mamejay/Amiga-USB-C-PD-Power-Supply/rev1.1/docs/renders/board_iso.png

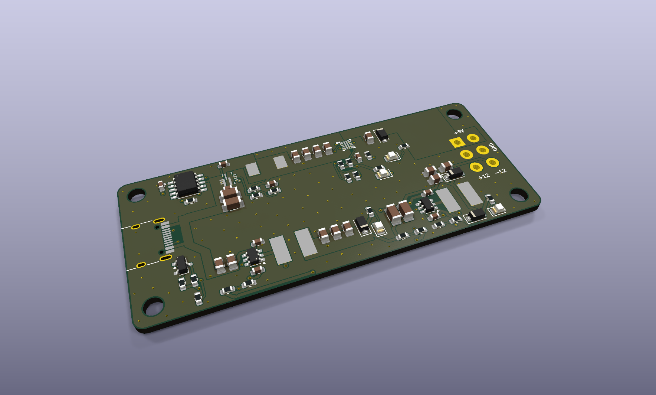
rev1.1/docs/renders/board_iso.png
