mamejay/Amiga-USB-C-PD-Power-Supply/rev1.1/docs/renders/board_top.png

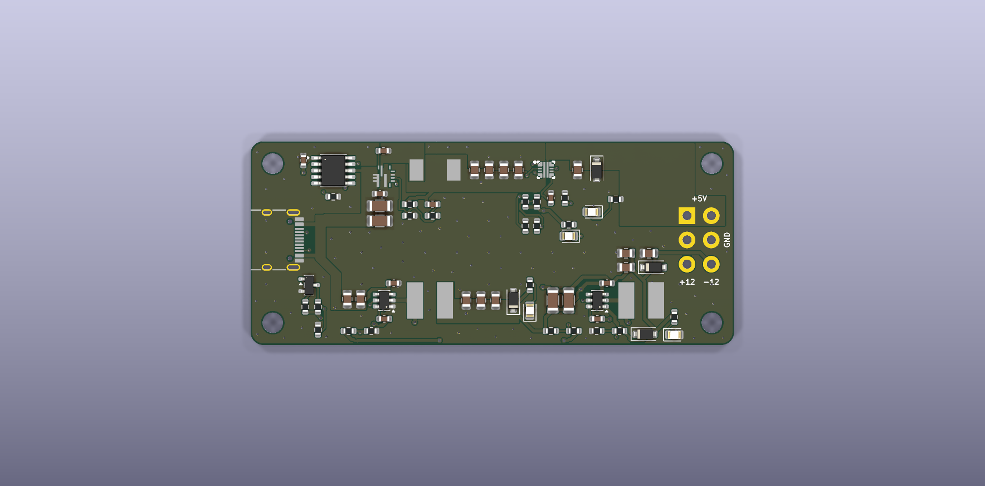
rev1.1/docs/renders/board_top.png
