mamejay/Amiga-USB-C-PD-Power-Supply/README.md

# Amiga USB-C PD Power Supply

A compact power supply that runs a Commodore **Amiga 500 / 600 / 1200** from a USB-C PD charger.
It asks the charger for **15 V** and makes the three Amiga rails on board:

| Rail | Converter | Set point | Rating | Protection |
|---|---|---|---|---|
| +5 V | Silergy SY8205 5 A sync buck → TI TPS259470A eFuse | 5.10 V | **4.5 A continuous** (same as the Commodore A500 PSU; eFuse limit ~5.4 A typ, 4.8 A min) | eFuse cuts the output above **5.64 V** (failed buck can't reach the Amiga), current limit, ~5 ms soft start, SMF5.0A TVS, red fault LED |
| +12 V | TI LMR51430 3 A sync buck | 12.36 V | 1.5 A (Commodore A500 PSU: 1 A; floppy / RS-232 / audio / expansion) | cycle-by-cycle limit + hiccup, SMF13A TVS |
| −12 V | TI LMR51430 as inverting buck-boost (from +12 V) | −12.36 V | 0.5 A+ (Commodore PSU: 0.1 A) | hiccup limit, Schottky clamp against positive excursions, SMF13A TVS |

Input power budget is 45 W (15 V × 3 A), e.g. 5 V 4.5 A + 12 V 1 A + −12 V 0.2 A ≈ 37 W out.
The converters only start once the charger has agreed 15 V (CH224A power-good) **and** VBUS is above ~11.5 V,
so a 5 V-only or non-PD source never powers the Amiga.

## Charger / cable
* USB-C **PD** charger that offers **15 V at 3 A** (any 45 W+ PD charger; 65 W recommended).
* USB-C to USB-C cable rated 3 A or more (normal 60 W cables are fine).

## Board
* **76 × 32 mm** slim board (rev 1.1 / 1.2), 2 layers, 1.6 mm, 1 oz. All SMD parts on the top side (JLCPCB economic PCBA).
* 4 × M3 mounting holes.
* **Cable pads (J2)**, a 2 × 3 block at the right-hand end, 1.4 mm holes (up to 18 AWG). Solder a ready-made Amiga square DIN-5 power cable:

  | Row (top to bottom) | Left pad | Right pad |
  |---|---|---|
  | 1 | +5 V (pad 1, square) | +5 V (pad 2) |
  | 2 | GND (pad 3) | GND (pad 4) |
  | 3 | +12 V (pad 5) | −12 V (pad 6) |

  **Identify every wire of the DIN cable with a multimeter against the Amiga power socket pinout before soldering.**
  Cable wire colours are not standard between suppliers.

* LEDs: green +5 V, green +12 V, green −12 V, red = 5 V eFuse fault.

## Two versions

| | **Rev 1.2** (repo root, recommended) | **Rev 1.1** (`rev1.1/` folder, higher capacity) |
|---|---|---|
| 5 V buck | SY8205, 5 A | TPS56637, 6 A |
| +5 V rating | 4.5 A continuous | **5 A continuous** |
| Parts per board (10 off) | about US$5.37 | about US$7.30 |

Everything else (board size, cable pads, ±12 V) is the same. Rev 1.1 suits heavily expanded machines; see `rev1.1/README.md`.

## Files
* `hw/` – KiCad 10 project (schematic, PCB, project symbol + footprint libraries, DRC/ERC reports).
* `fab/` – JLCPCB order files: Gerbers zip, BOM, CPL and `ORDER NOTES.md`.
* `scripts/` – the generators: `gen_sch.py` (schematic), `place.py` + `build_pcb.py` (placement/board),
  `full.sh` (net classes → Freerouting → pours → GND stitching → DRC loop), `make_fab.py`, `bom_cost.py`.
* `rev1.1/` – complete rev 1.1 (5 A) KiCad project, JLC files and design notes.
* `datasheets/` – not committed (vendor copyright); see the links in `docs/DESIGN.md`.

## Status
Rev 1.2 (cost-down of the slim 76 × 32 mm rev 1.1: SY8205 5 V buck, Fojan 22 µF caps) – routed, ERC 0 / DRC 0
(only 2 cosmetic USB-C silk-at-edge marks), JLC files generated, **not yet built**.
Parts ≈ US$5.37 per board at 10 boards (JLC prices 2026-11-03), 8 extended parts, every part Economic-PCBA eligible.
Rev 1.1 (5 A) is in `rev1.1/` and tagged `v1.1`; rev 1.0 (64 × 46 mm) is tagged `v1.0`. See `docs/DESIGN.md` for the calculations and the bring-up checklist.

## Licence
Copyright © 2026 mamejay. All rights reserved (commercial product). See `LICENSE` and `NOTICE.md`.
