mamejay/Amiga-USB-C-PD-Power-Supply/rev1.1/docs/renders/board_bottom.png

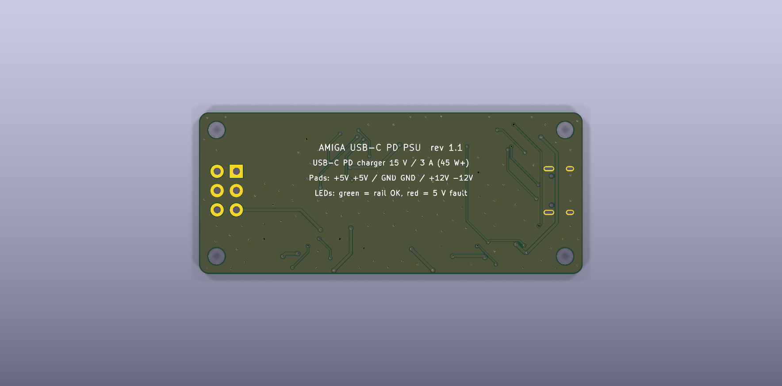
rev1.1/docs/renders/board_bottom.png
