mamejay/Amiga-USB-C-PD-Power-Supply/rev1.1/docs/renders/copper_top.png

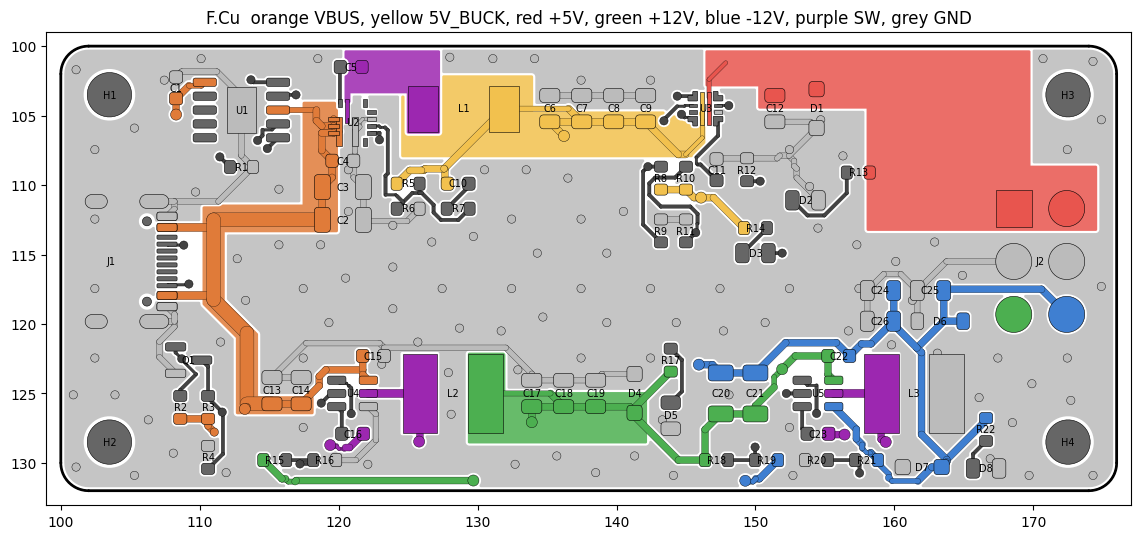
rev1.1/docs/renders/copper_top.png
