mamejay/Amiga-USB-C-PD-Power-Supply/rev1.1/docs/renders/schematic-1.png

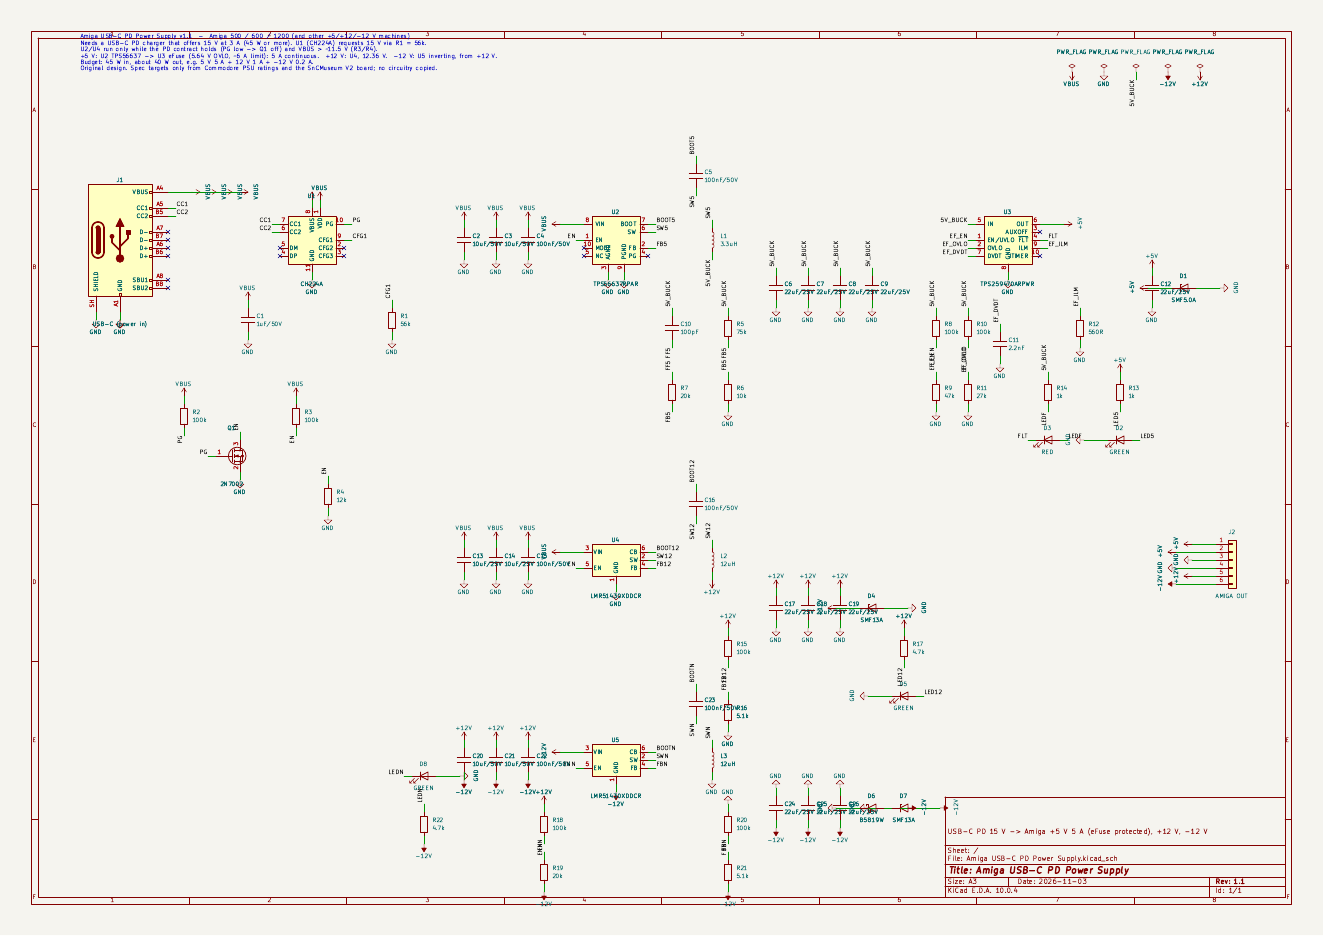
rev1.1/docs/renders/schematic-1.png
