mamejay/Amiga-USB-C-PD-Power-Supply/rev1.1/fab/Amiga USB-C PD Power Supply - BOM.csv

Comment | Designator | Footprint | LCSC Part #
1uF/50V | C1 | 0603 | C15849
10uF/50V | C2,C3,C20,C21 | 1206 | C13585
100nF/50V | C4,C5,C15,C16,C22,C23 | 0603 | C14663
22uF/25V | C6,C7,C8,C9,C12,C17,C18,C19,C24,C25,C26 | 0805 | C7419435
100pF | C10 | 0603 | C14858
2.2nF | C11 | 0603 | C1604
10uF/25V | C13,C14 | 0805 | C15850
SMF5.0A | D1 | SOD-123F | C19077497
GREEN | D2,D5,D8 | 0805 | C2297
RED | D3 | 0805 | C84256
SMF13A | D4,D7 | SOD-123F | C41376087
B5819W | D6 | SOD-123 | C8598
USB-C (power in) | J1 | TYPE-C-31-M-12 | C165948
3.3uH | L1 | CMLO0650H | C439008
12uH | L2,L3 | L_FH_FNR6045 | C168077
2N7002 | Q1 | SOT-23 | C8545
56k | R1 | 0603 | C23206
100k | R2,R3,R8,R10,R15,R18,R20 | 0603 | C25803
12k | R4 | 0603 | C22790
75k | R5 | 0603 | C23242
10k | R6 | 0603 | C25804
20k | R7,R19 | 0603 | C4184
47k | R9 | 0603 | C25819
27k | R11 | 0603 | C22967
560R | R12 | 0603 | C23204
1k | R13,R14 | 0603 | C21190
5.1k | R16,R21 | 0603 | C23186
4.7k | R17,R22 | 0603 | C23162
CH224A | U1 | SSOP-10 | C42459160
TPS56637RPAR | U2 | VQFN-HR-10_3x3 | C841386
TPS259470ARPWR | U3 | VQFN-10-HR_2x2 | C3662799
LMR51430XDDCR | U4,U5 | TSOT-23-6 | C5185863
