mamejay/Amiga-USB-C-PD-Power-Supply/rev1.1/hw/Amiga USB-C PD Power Supply - schematic.pdf

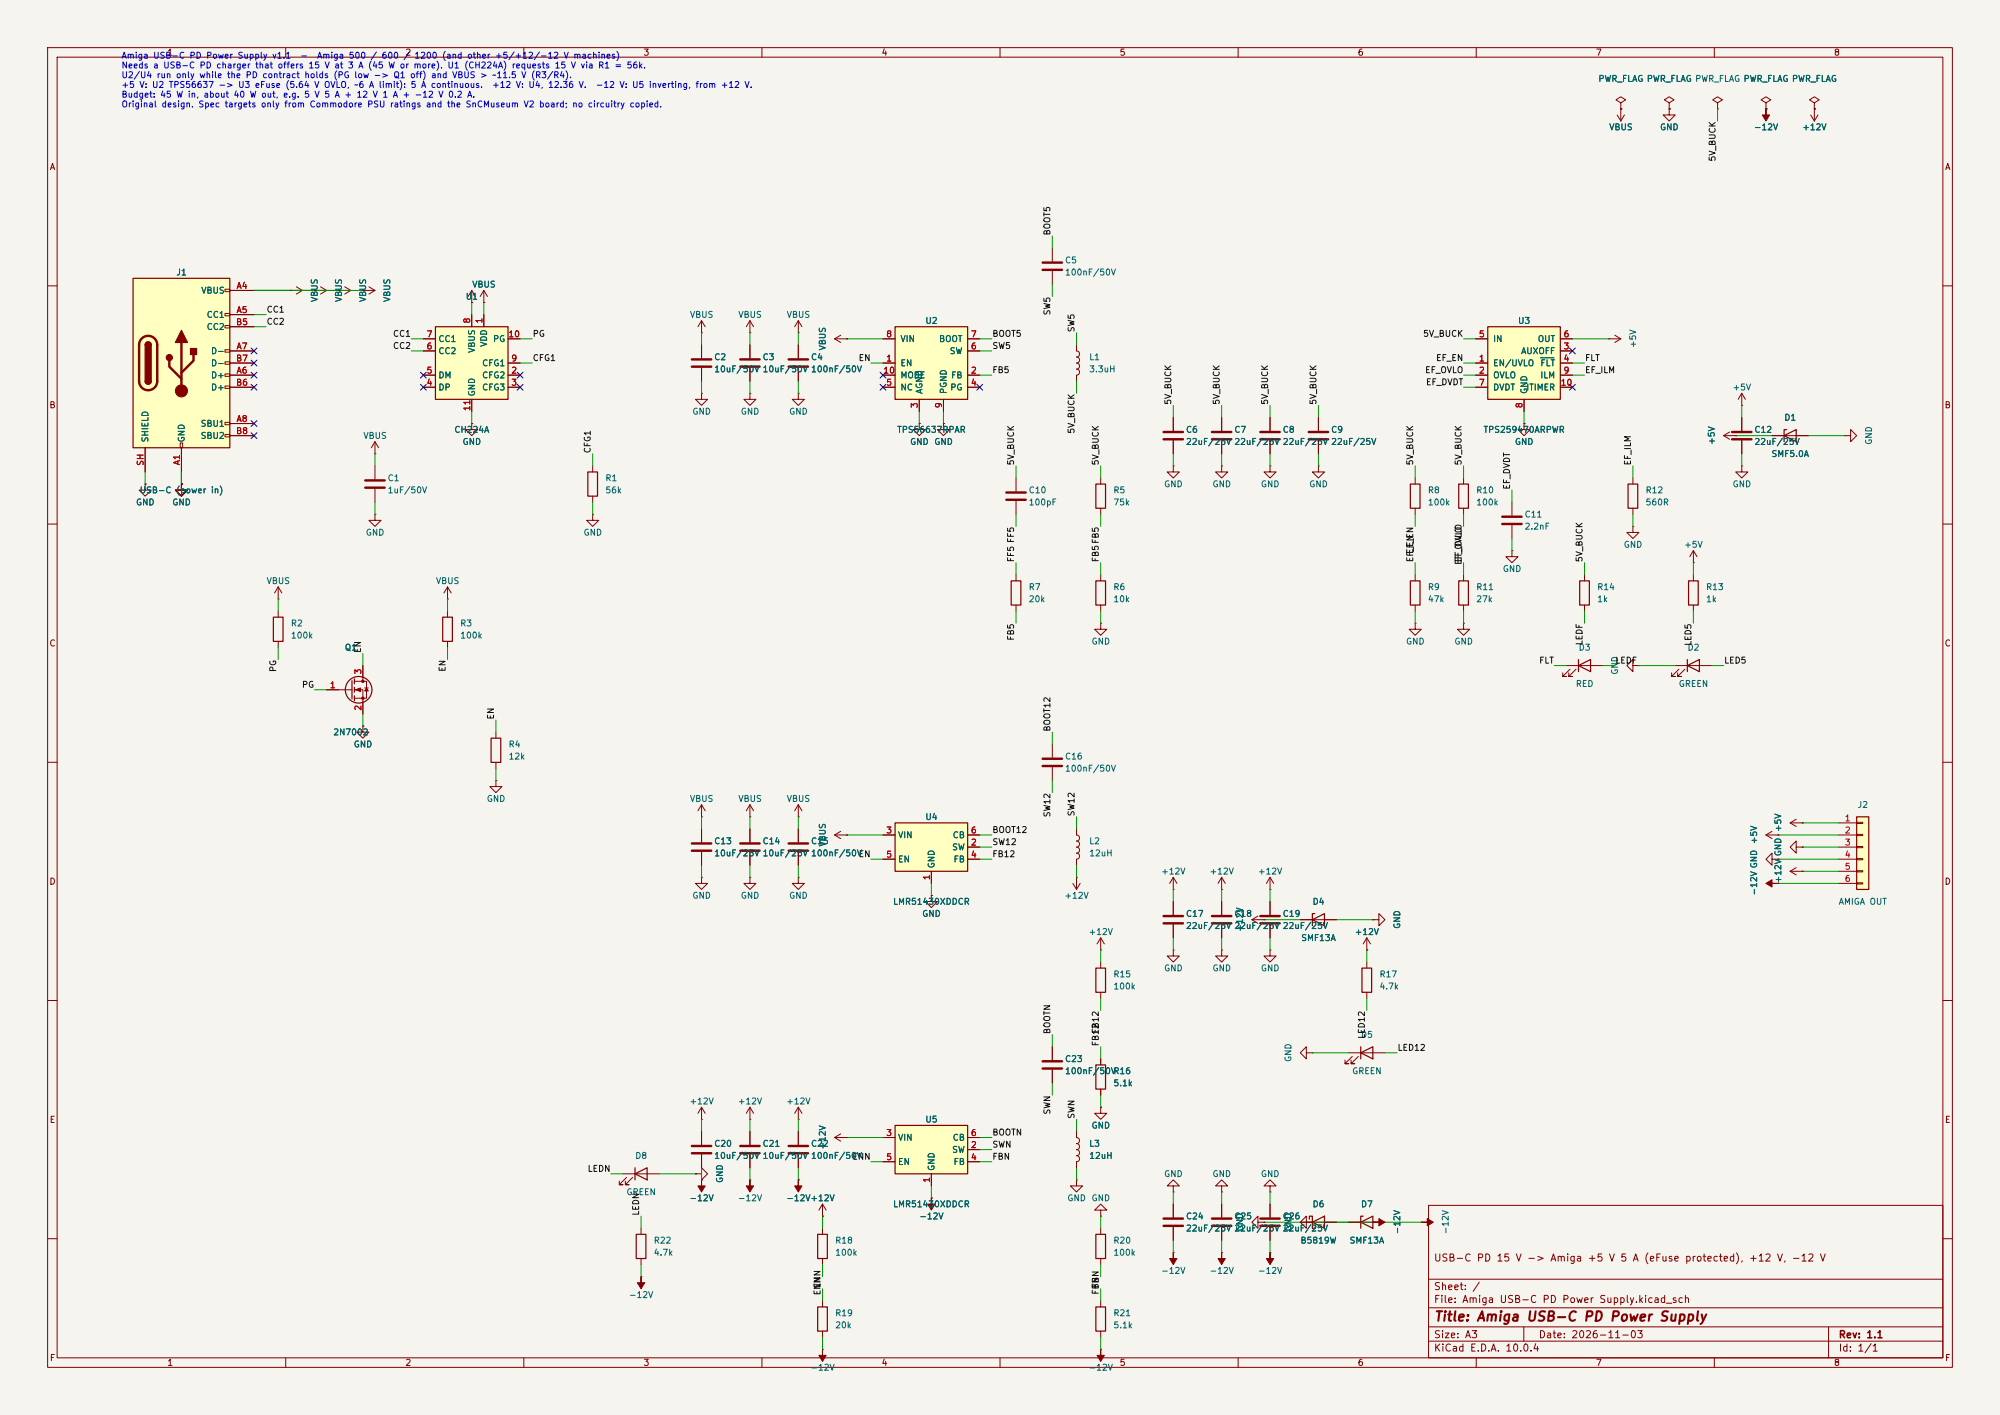
[picture p7: page 1]

J1 USB-C (power in) GND A1

USB-C PD 15 V -> Amiga +5 V 5 A (eFuse protected), +12 V, -12 V

Sheet: /
File: Amiga USB-C PD Power Supply.kicad_sch
Title: Amiga USB-C PD Power Supply

Size: A3 | Rev: 1.1
KiCad E.D.A. 10.0.4 | Id: 1/1 | F Date: 2026-11-03
