mamejay/Amiga-USB-C-PD-Power-Supply/hw/Amiga USB-C PD Power Supply - schematic.pdf

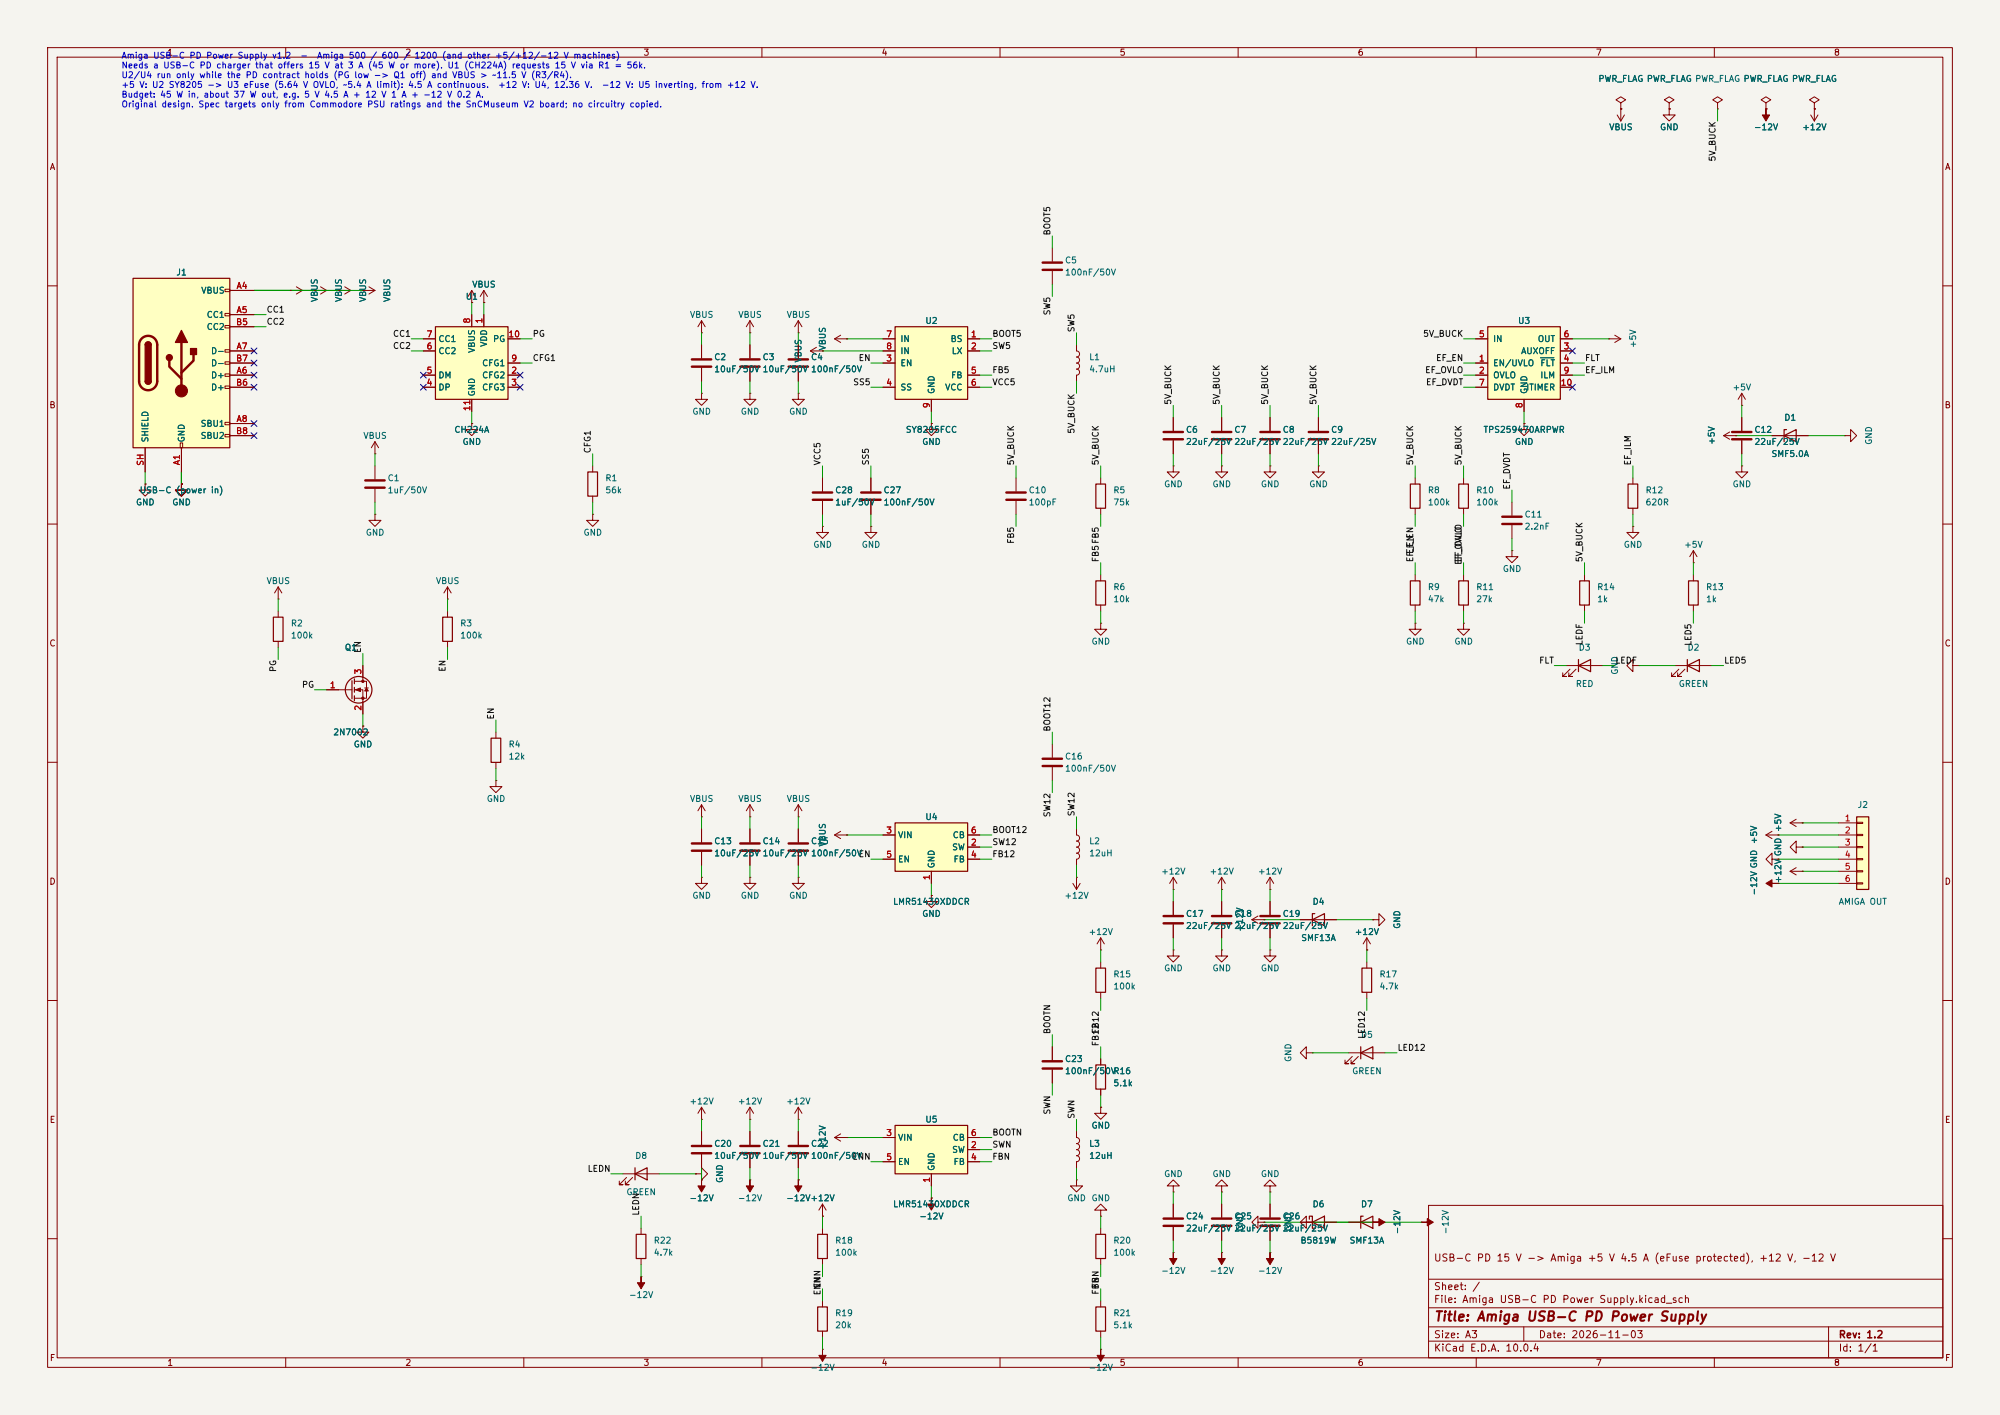
[picture p8: page 1]

Amiga USB-C PD Power Supply v1.2 - Amiga 500 / 600 / 1200 (and other +5/+12/-12 V machines) Needs a USB-C PD charger that offers 15 V at 3 A (45 W or more). U1 (CH224A) requests 15 V via R1 = 56k. U2/U4 run only while the PD contract holds (PG low -> Q1 off) and VBUS > ~11.5 V (R3/R4). +5 V: U2 SY8205 -> U3 eFuse (5.64 V OVLO, ~5.4 A limit): 4.5 A continuous. +12 V: U4, 12.36 V. -12 V: U5 inverting, from +12 V. Budget: 45 W in, about 37 W out, e.g. 5 V 4.5 A + 12 V 1 A + -12 V 0.2 A. Original design. Spec targets only from Commodore PSU ratings and the SnCMuseum V2 board; no circuitry copied. J1 USB-C (power in) GND A1

USB-C PD 15 V -> Amiga +5 V 4.5 A (eFuse protected), +12 V, -12 V

Sheet: /
File: Amiga USB-C PD Power Supply.kicad_sch
Title: Amiga USB-C PD Power Supply

Size: A3 | Rev: 1.2
KiCad E.D.A. 10.0.4 | Id: 1/1 | F Date: 2026-11-03
