mamejay/Amiga-USB-C-PD-Power-Supply/rev1.1/hw/Amiga USB-C PD Power Supply.kicad_pcb

## KiCad design rev1.1/hw/Amiga USB-C PD Power Supply.kicad_pcb (2026-11-03)

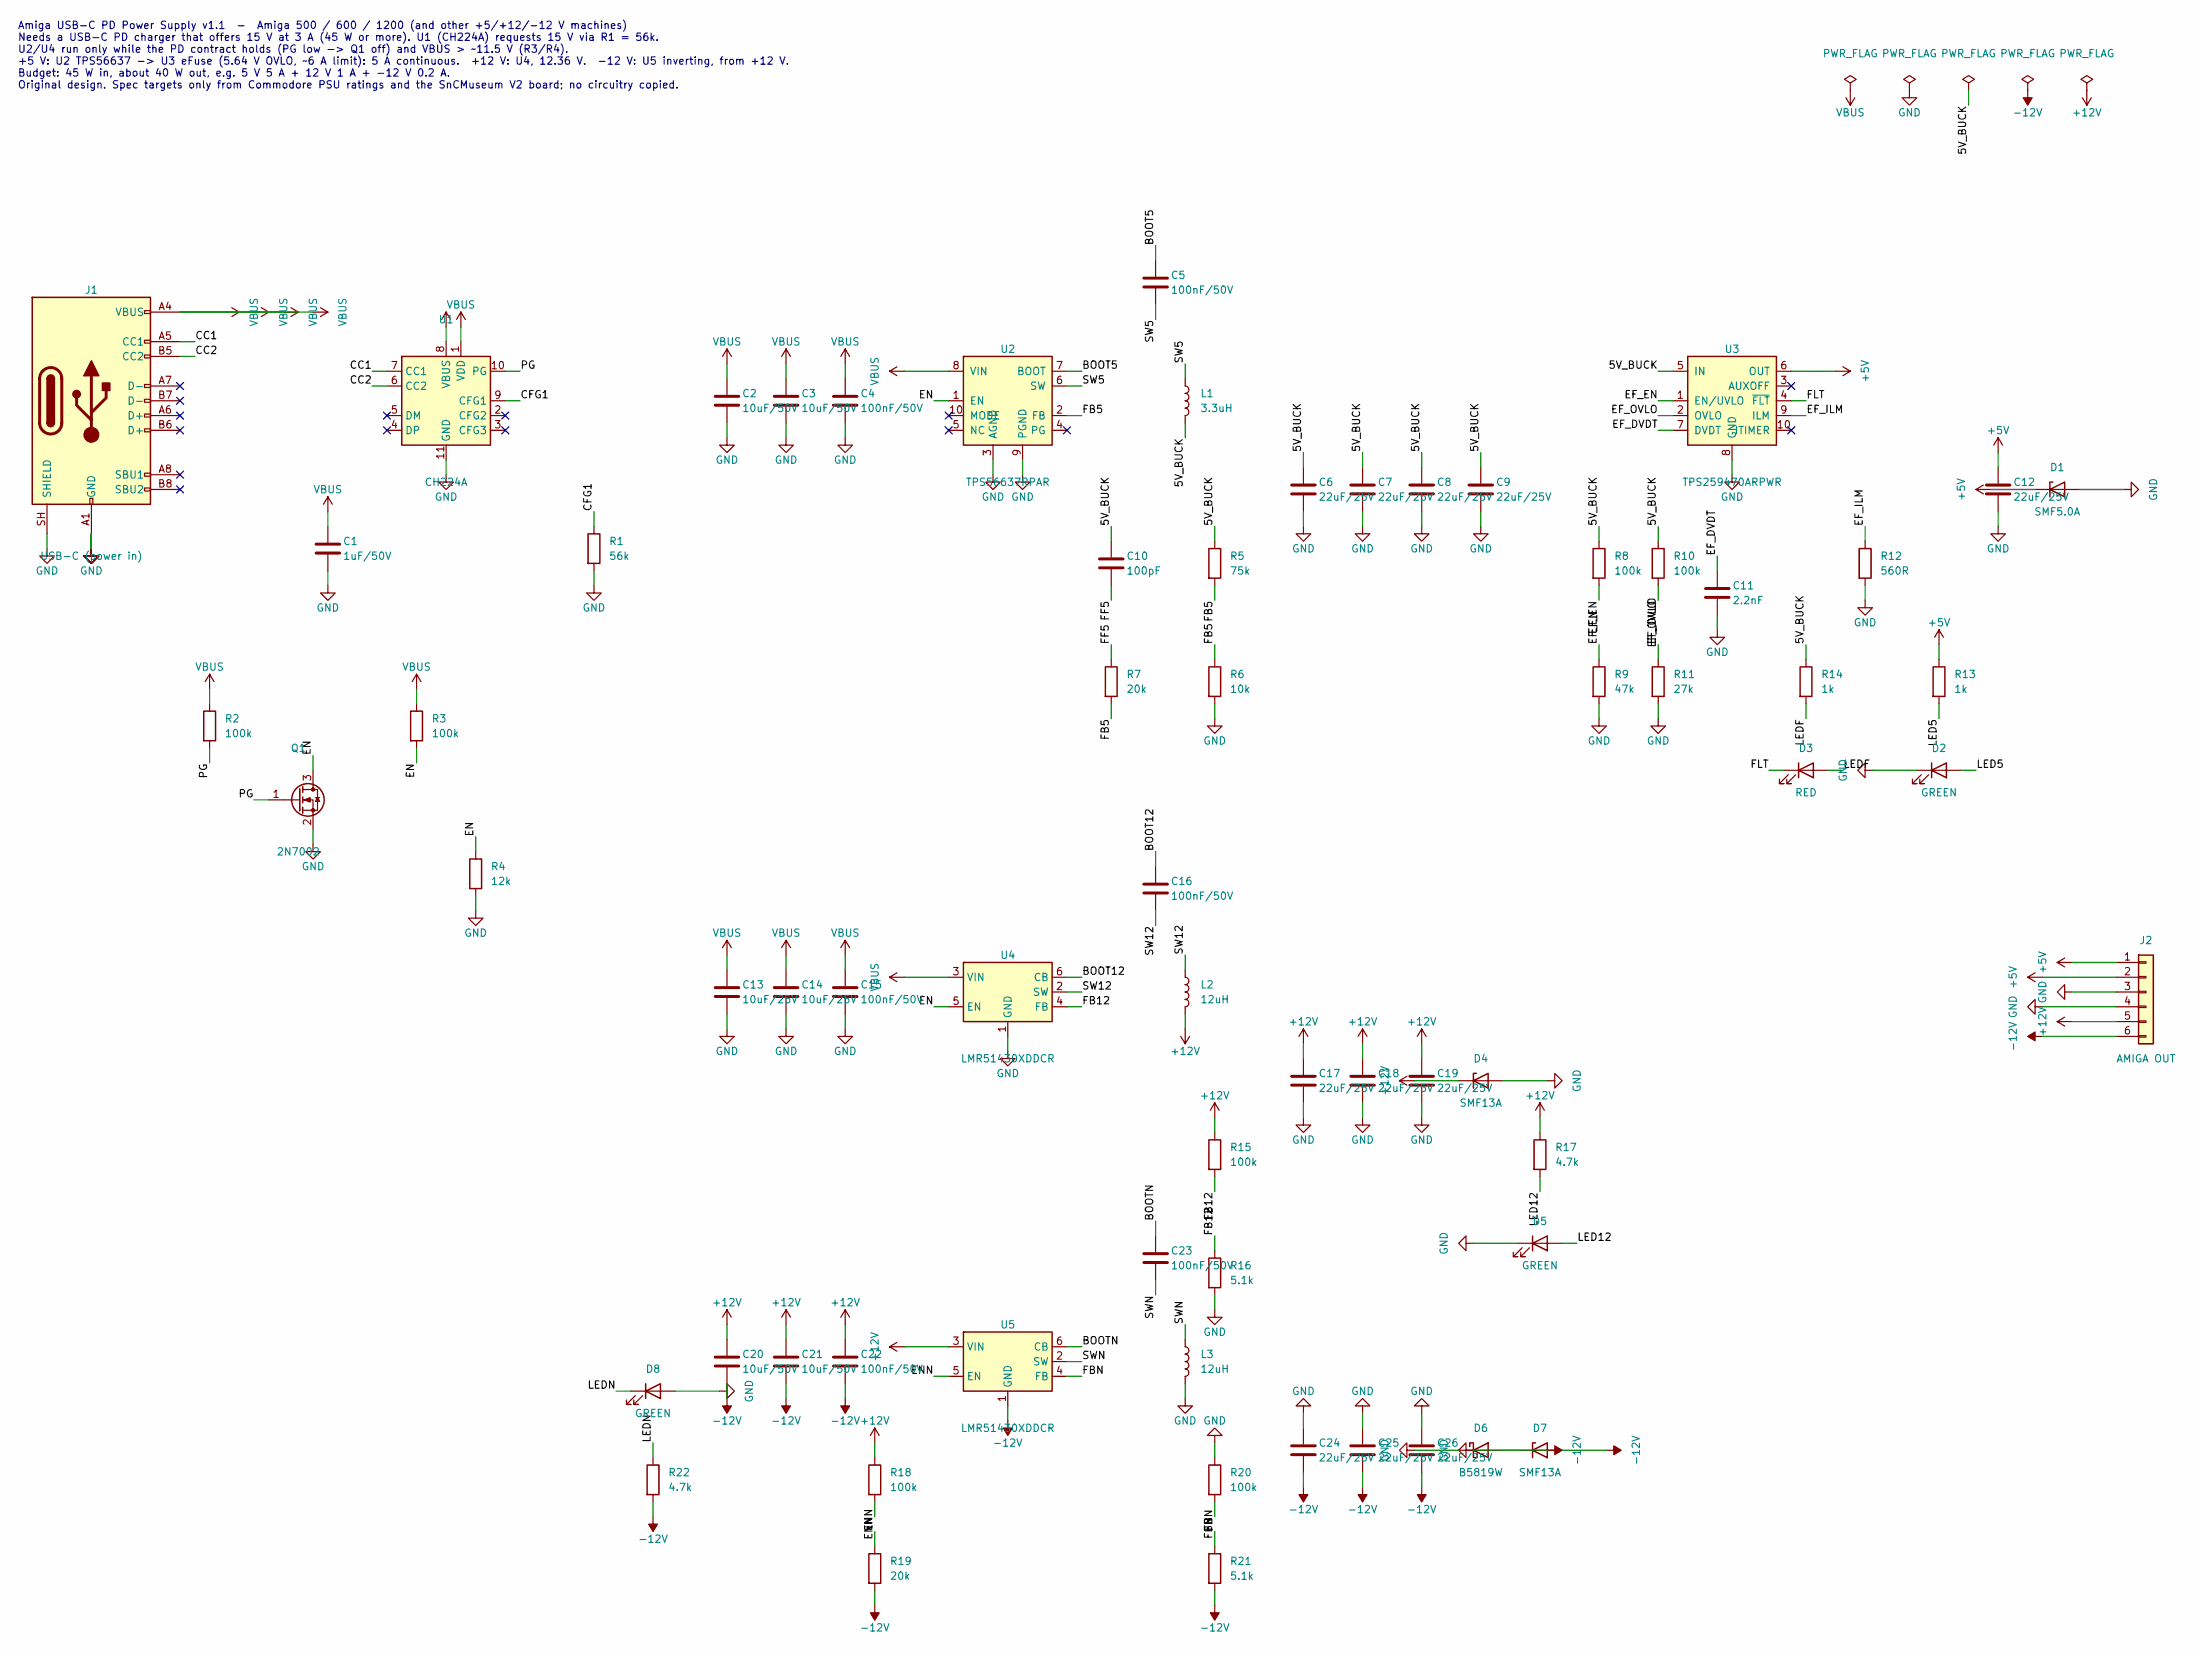
[picture p9: schematic Amiga USB-C PD Power Supply.kicad_sch]

Parts:
C1: 1uF/50V; C_0603_1608Metric; LCSC C15849
C2, C3, C20, C21: 10uF/50V; C_1206_3216Metric; LCSC C13585
C4, C5, C15, C16, C22, C23: 100nF/50V; C_0603_1608Metric; LCSC C14663
C6, C7, C8, C9, C12, C17, C18, C19, C24, C25, C26: 22uF/25V; C_0805_2012Metric; LCSC C7419435
C10: 100pF; C_0603_1608Metric; LCSC C14858
C11: 2.2nF; C_0603_1608Metric; LCSC C1604
C13, C14: 10uF/25V; C_0805_2012Metric; LCSC C15850
D1: SMF5.0A; D_SOD-123F; LCSC C19077497
D2, D5, D8: GREEN; LED_0805_2012Metric; LCSC C2297
D3: RED; LED_0805_2012Metric; LCSC C84256
D4, D7: SMF13A; D_SOD-123F; LCSC C41376087
D6: B5819W; D_SOD-123; LCSC C8598
J1: USB-C (power in); USB_C_Receptacle_HRO_TYPE-C-31-M-12; LCSC C165948
J2: AMIGA OUT; WirePads_2x03_P3.81mm_D1.4mm
L1: 3.3uH; L_Chilisin_CMLO0650H; LCSC C439008
L2, L3: 12uH; L_FH_FNR6045; LCSC C168077
Q1: 2N7002; SOT-23; LCSC C8545
R1: 56k; R_0603_1608Metric; LCSC C23206
R2, R3, R8, R10, R15, R18, R20: 100k; R_0603_1608Metric; LCSC C25803
R4: 12k; R_0603_1608Metric; LCSC C22790
R5: 75k; R_0603_1608Metric; LCSC C23242
R6: 10k; R_0603_1608Metric; LCSC C25804
R7, R19: 20k; R_0603_1608Metric; LCSC C4184
R9: 47k; R_0603_1608Metric; LCSC C25819
R11: 27k; R_0603_1608Metric; LCSC C22967
R12: 560R; R_0603_1608Metric; LCSC C23204
R13, R14: 1k; R_0603_1608Metric; LCSC C21190
R16, R21: 5.1k; R_0603_1608Metric; LCSC C23186
R17, R22: 4.7k; R_0603_1608Metric; LCSC C23162
U1: CH224A; SSOP-10-1EP_3.9x4.9mm_P1mm_EP2.1x3.3mm; LCSC C42459160
U2: TPS56637RPAR; TI_RPA0010A_VQFN-HR-10_3x3mm; LCSC C841386
U3: TPS259470ARPWR; TI_RPW0010A_VQFN-10-HR_2x2mm; LCSC C3662799
U4, U5: LMR51430XDDCR; TSOT-23-6; LCSC C5185863

Connections:
+5V: C12.1, D1.1 (K), J2.1, J2.2, R13.1, U3.6 (OUT)
+12V: C17.1, C18.1, C19.1, C20.1, C21.1, C22.1, D4.1 (K), J2.5, L2.2, R15.1, R17.1, R18.1, U5.3 (VIN)
-12V: C20.2, C21.2, C22.2, C24.2, C25.2, C26.2, D6.2 (A), D7.2 (A), J2.6, R19.2, R21.2, R22.2, U5.1 (GND)
/5V_BUCK: C6.1, C7.1, C8.1, C9.1, C10.1, L1.2, R5.1, R8.1, R10.1, R14.1, U3.5 (IN)
/BOOT5: C5.1, U2.7 (BOOT)
/BOOT12: C16.1, U4.6 (CB)
/BOOTN: C23.1, U5.6 (CB)
/CC1: J1.A5 (CC1), U1.7 (CC1)
/CC2: J1.B5 (CC2), U1.6 (CC2)
/CFG1: R1.1, U1.9 (CFG1)
/EF_DVDT: C11.1, U3.7 (DVDT)
/EF_EN: R8.2, R9.1, U3.1 (EN/UVLO)
/EF_ILM: R12.1, U3.9 (ILM)
/EF_OVLO: R10.2, R11.1, U3.2 (OVLO)
/EN: Q1.3 (D), R3.2, R4.1, U2.1 (EN), U4.5 (EN)
/ENN: R18.2, R19.1, U5.5 (EN)
/FB5: R5.2, R6.1, R7.2, U2.2 (FB)
/FB12: R15.2, R16.1, U4.4 (FB)
/FBN: R20.2, R21.1, U5.4 (FB)
/FF5: C10.2, R7.1
/FLT: D3.1 (K), U3.4 (~FLT)
/LED5: D2.2 (A), R13.2
/LED12: D5.2 (A), R17.2
/LEDF: D3.2 (A), R14.2
/LEDN: D8.1 (K), R22.1
/PG: Q1.1 (G), R2.2, U1.10 (PG)
/SW5: C5.2, L1.1, U2.6 (SW)
/SW12: C16.2, L2.1, U4.2 (SW)
/SWN: C23.2, L3.1, U5.2 (SW)
GND: C1.2, C2.2, C3.2, C4.2, C6.2, C7.2, C8.2, C9.2, C11.2, C12.2, C13.2, C14.2, C15.2, C17.2, C18.2, C19.2, C24.1, C25.1, C26.1, D1.2 (A), D2.1 (K), D4.2 (A), D5.1 (K), D6.1 (K), D7.1 (K), D8.2 (A), J1.A1 (GND), J1.A12 (GND), J1.B1 (GND), J1.B12 (GND), J1.SH (SHIELD), J2.3, J2.4, L3.2, Q1.2 (S), R1.2, R4.2, R6.2, R9.2, R11.2, R12.2, R16.2, R20.1, U1.11 (GND), U2.3 (AGND), U2.9 (PGND), U3.8 (GND), U4.1 (GND)
VBUS: C1.1, C2.1, C3.1, C4.1, C13.1, C14.1, C15.1, J1.A4 (VBUS), J1.A9 (VBUS), J1.B4 (VBUS), J1.B9 (VBUS), R2.1, R3.1, U1.1 (VDD), U1.8 (VBUS), U2.8 (VIN), U4.3 (VIN)

Notes on the sheet:
Amiga USB-C PD Power Supply v1.1 - Amiga 500 / 600 / 1200 (and other +5/+12/-12 V machines) Needs a USB-C PD charger that offers 15 V at 3 A (45 W or more). U1 (CH224A) requests 15 V via R1 = 56k. U2/U4 run only while the PD contract holds (PG low -> Q1 off) and VBUS > ~11.5 V (R3/R4). +5 V: U2 TPS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

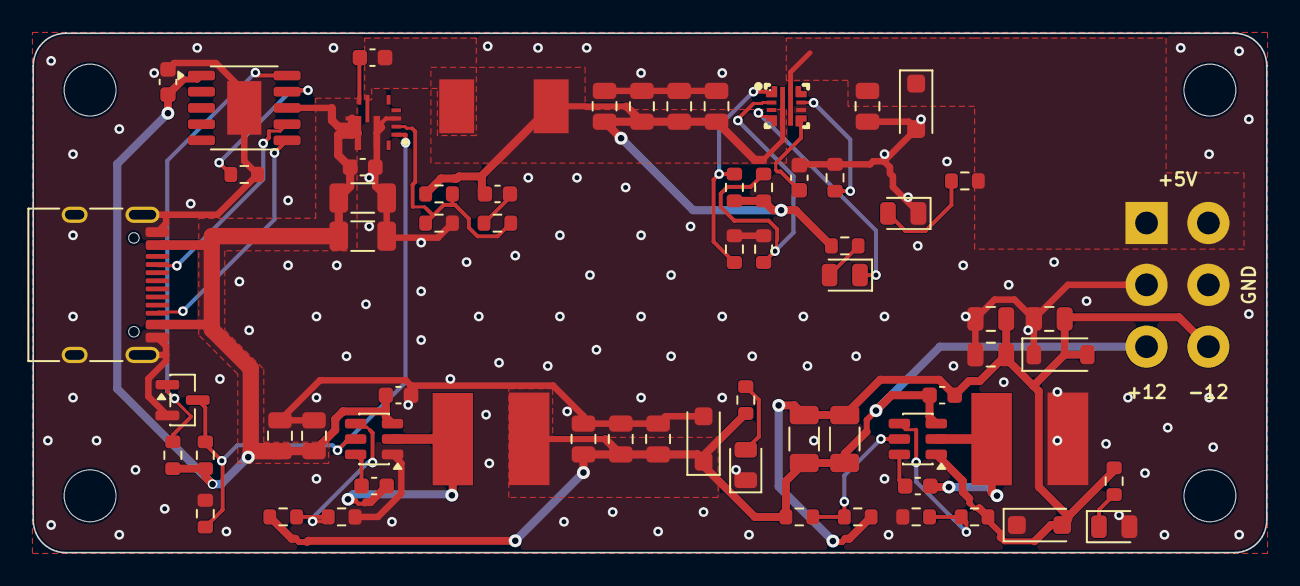
[picture p10: board Amiga USB-C PD Power Supply.kicad_pcb from above]

Board: 2 copper layers, 76.0 x 32.0 mm, 71 parts (0 on the bottom side), 31 nets.

Other parts of the board:
H1, H2, H3, H4: M3; MountingHole_3.2mm_M3
