mamejay/Amiga-USB-C-PD-Power-Supply/(commit log)

2026-11-03 Amiga USB-C PD Power Supply rev 1.0: schematic, routed board, JLC files
    Original design: CH224A 15 V PD sink, TPS56637 6 A buck + TPS259470A eFuse (+5 V, 5.64 V OVLO),
    LMR51430 +12 V buck and LMR51430 inverting -12 V. ERC 0, DRC 0 (2 cosmetic silk-edge marks).
    [Amiga USB-C PD Power Supply - BOM.csv, Amiga USB-C PD Power Supply.kicad_pcb, Amiga USB-C PD Power Supply.kicad_sch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]
2026-11-03 CPL: JLC rotation fixes U1/U4/U5 -90 (from JLC preview), Q1 +180
    [Amiga USB-C PD Power Supply - CPL.csv]
2026-11-03 Rev 1.1: slim 76 x 32 mm layout (was 64 x 46)
    Two rows (5 V chain on top, +12 V / -12 V below), CH224A top-left, 2x3 cable pads at the right end,
    12 uH inductors now FNR6045 6x6 mm (C168077). +5 V output path is pre-routed copper; VBUS spine re-routed;
    GND via placement is net-aware. ERC 0, DRC 0 (2 cosmetic USB-C silk-edge marks). CPL keeps the JLC rotation fixes.
    [Amiga USB-C PD Power Supply - BOM.csv, Amiga USB-C PD Power Supply.kicad_pcb, Amiga USB-C PD Power Supply.kicad_sch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]
2026-11-03 Add pcba_type.py: report JLC Economic/Standard PCBA eligibility per BOM part
2026-11-03 Cost-down: 22 uF/25 V 0805 caps -> Fojan FCC0805X226M250FT C7419435 (drop-in, $0.077 vs $0.184)
    Parts ~$8.48 -> ~$7.30 per board at 10 boards; one more extended part (net saving ~$8.80 per 10).
    [Amiga USB-C PD Power Supply - BOM.csv, Amiga USB-C PD Power Supply.kicad_pcb, Amiga USB-C PD Power Supply.kicad_sch]
2026-11-03 Rev 1.2 cost-down: SY8205 5 V buck (4.5 A rating), 4.7 uH L1, 620R eFuse limit
    U2 TPS56637 -> SY8205FCC (C111875, SO-8E) with SS/VCC caps, C10 100 pF across R5 (R7 removed),
    L1 CMLO0650H4R7MTT (C439009), eFuse ILM 620R (C23220, ~5.4 A). 5 V block re-placed; locked
    U1 VBUS -> U2 IN link, pad-relative SW5 copper, -12 V boot-cap jumper. ERC 0, DRC 0 (2 cosmetic
    silk-edge marks). Parts ~$5.37/board at 10, all Economic-PCBA eligible. ORDER NOTES: not OSP.
    [Amiga USB-C PD Power Supply - BOM.csv, Amiga USB-C PD Power Supply.kicad_pcb, Amiga USB-C PD Power Supply.kicad_sch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]
2026-11-03 CPL: U2 (SY8205) -90 from JLC preview
    [Amiga USB-C PD Power Supply - CPL.csv]
2026-11-04 Add rev 1.1 (TPS56637, 5 A) alongside rev 1.2 for a higher-capacity option
    [Amiga USB-C PD Power Supply - BOM.csv, Amiga USB-C PD Power Supply.kicad_pcb, Amiga USB-C PD Power Supply.kicad_sch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]
